huconn/HPB-01/reference/hy_ip5328_test_v10b.pdf

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
D | D
C | C
B | B
A | A
Revision | Description | Date | Drawn | Checked
V10A | init | 2020-09-27 | xxxlzjxxx
V10B | init | 2020-10-30 | xxxlzjxxx

# 02 CHARGER

# COVER

Schematics Index: | BUG

# Power Block:

# Schematics Block:

# 01 COVER

# 3.7V 100Ah TAFER电池充电板

# max/min:4.3V/2.8V

# max充电:1C 100A

# max放电:2.5C 255A

Title

Size Size Size A3 A3 A3 | Document Number Document Number Document Number 01 COVER 01 COVER 01 COVER | Rev Rev Rev V10B V10B V10B
Date: Date: Date: Friday, October 30, 2020 Friday, October 30, 2020 Friday, October 30, 2020 | Sheet Sheet Sheet 1 1 1 of of of 2 2 2

## SICHUAN HUIYUAN OPTICAL COMMUNICATIONS CO.,LTD

hyoc.com.cn | Designed | Checked | Approved

汇源光通信

HY_IP5328_TEST_V10B

Title

## SICHUAN HUIYUAN OPTICAL COMMUNICATIONS CO.,LTD

hyoc.com.cn | Designed | Checked | Approved

汇源光通信

HY_IP5328_TEST_V10B

Title

## SICHUAN HUIYUAN OPTICAL COMMUNICATIONS CO.,LTD

hyoc.com.cn | Designed | Checked | Approved

汇源光通信

HY_IP5328_TEST_V10B

5

4

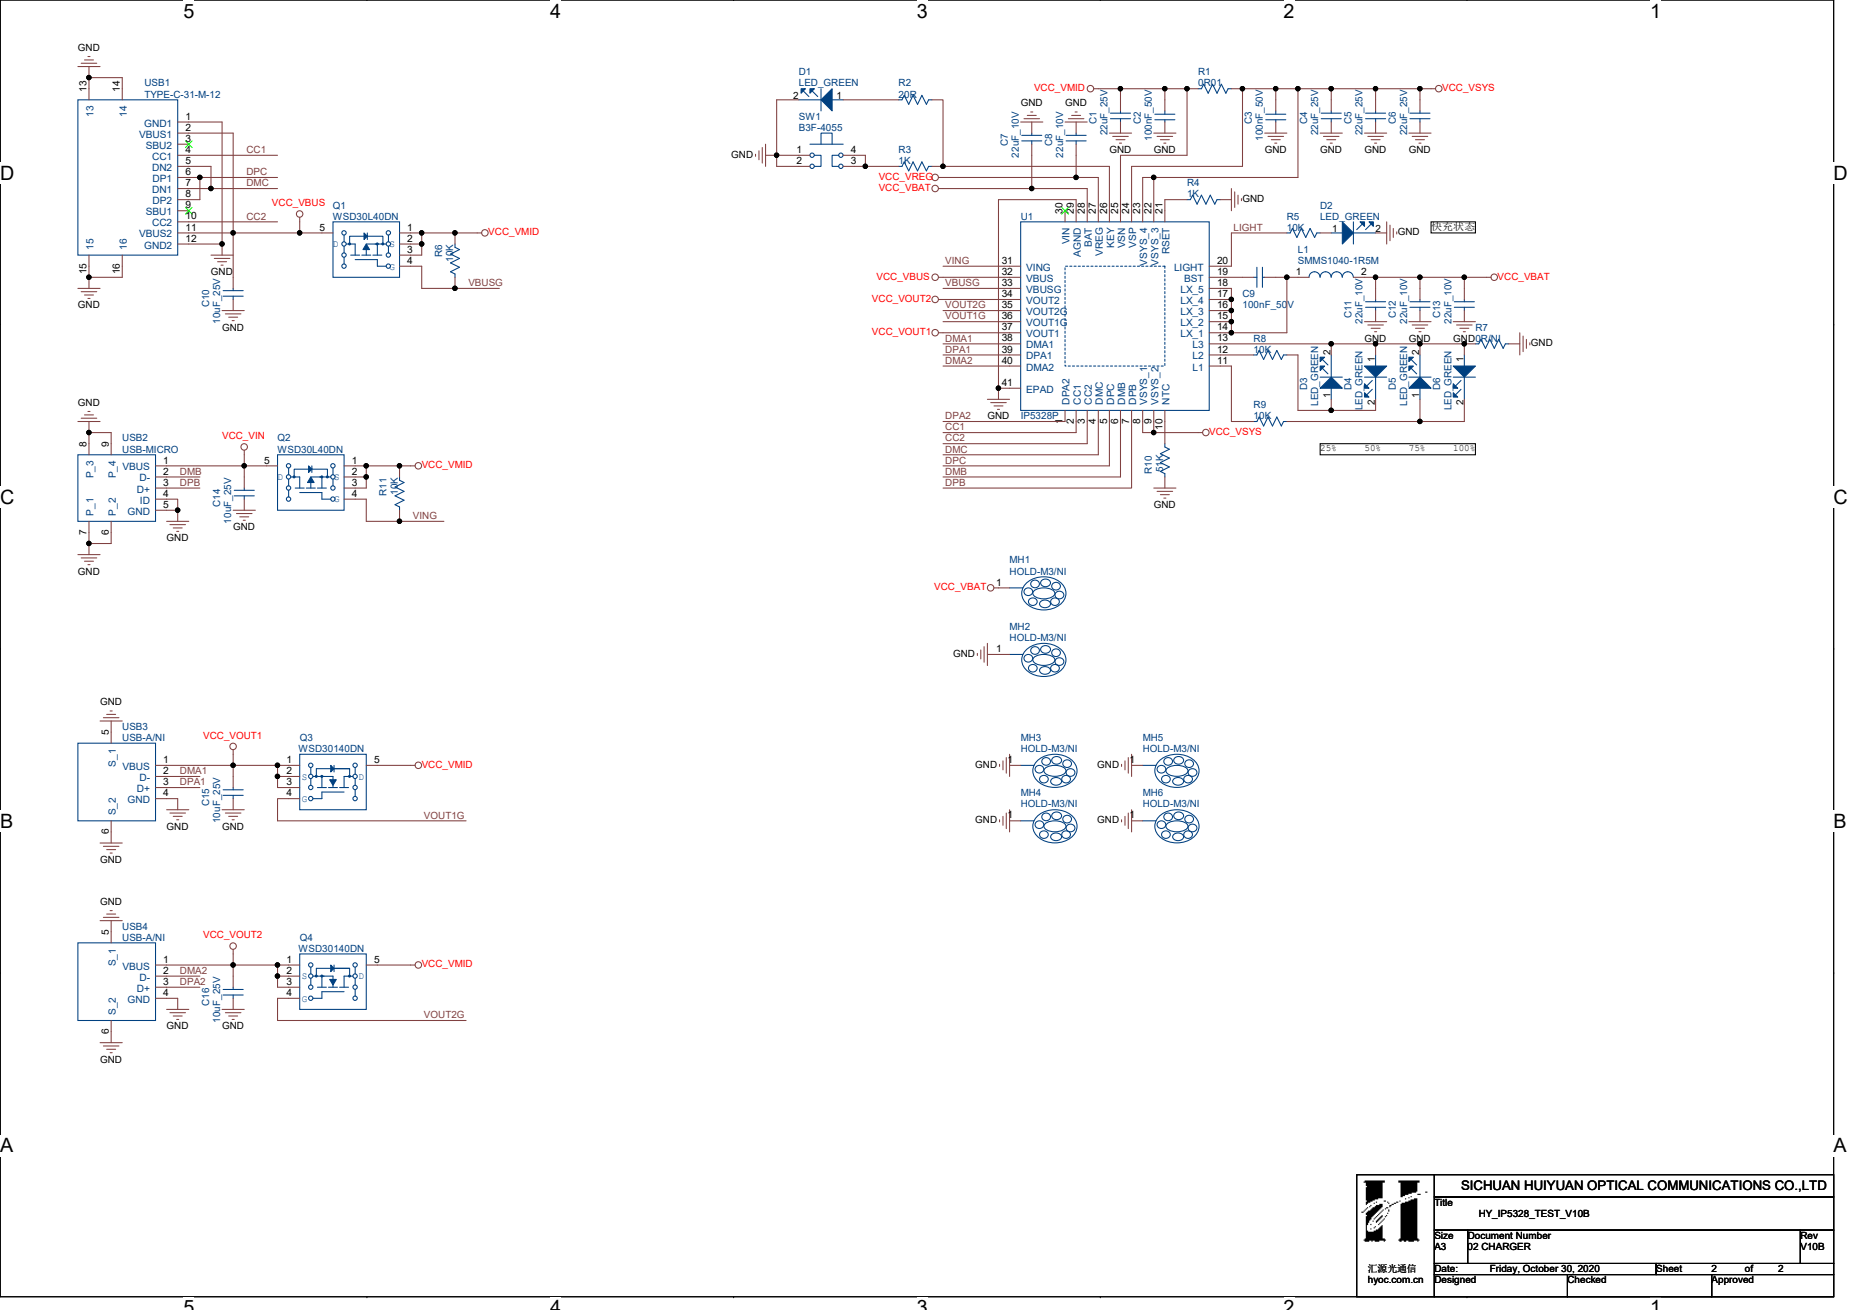
[picture p1: page 2]

SICHUAN HUIYUAN OPTICAL COMMUNICATIONS CO.,LTD
Title

Size Size Size A3 A3 A3 | Document Number Document Number Document Number 02 CHARGER 02 CHARGER 02 CHARGER | Rev Rev Rev V10B V10B V10B

Date: Date: Date: Friday, October 30, 2020 Friday, October 30, 2020 Friday, October 30, 2020 | Sheet Sheet Sheet 2 2 2 of of of 2 2 2
