huconn/HPB-01/HPB-01.kicad_pcb

## KiCad design HPB-01.kicad_pcb (2022-02-15)

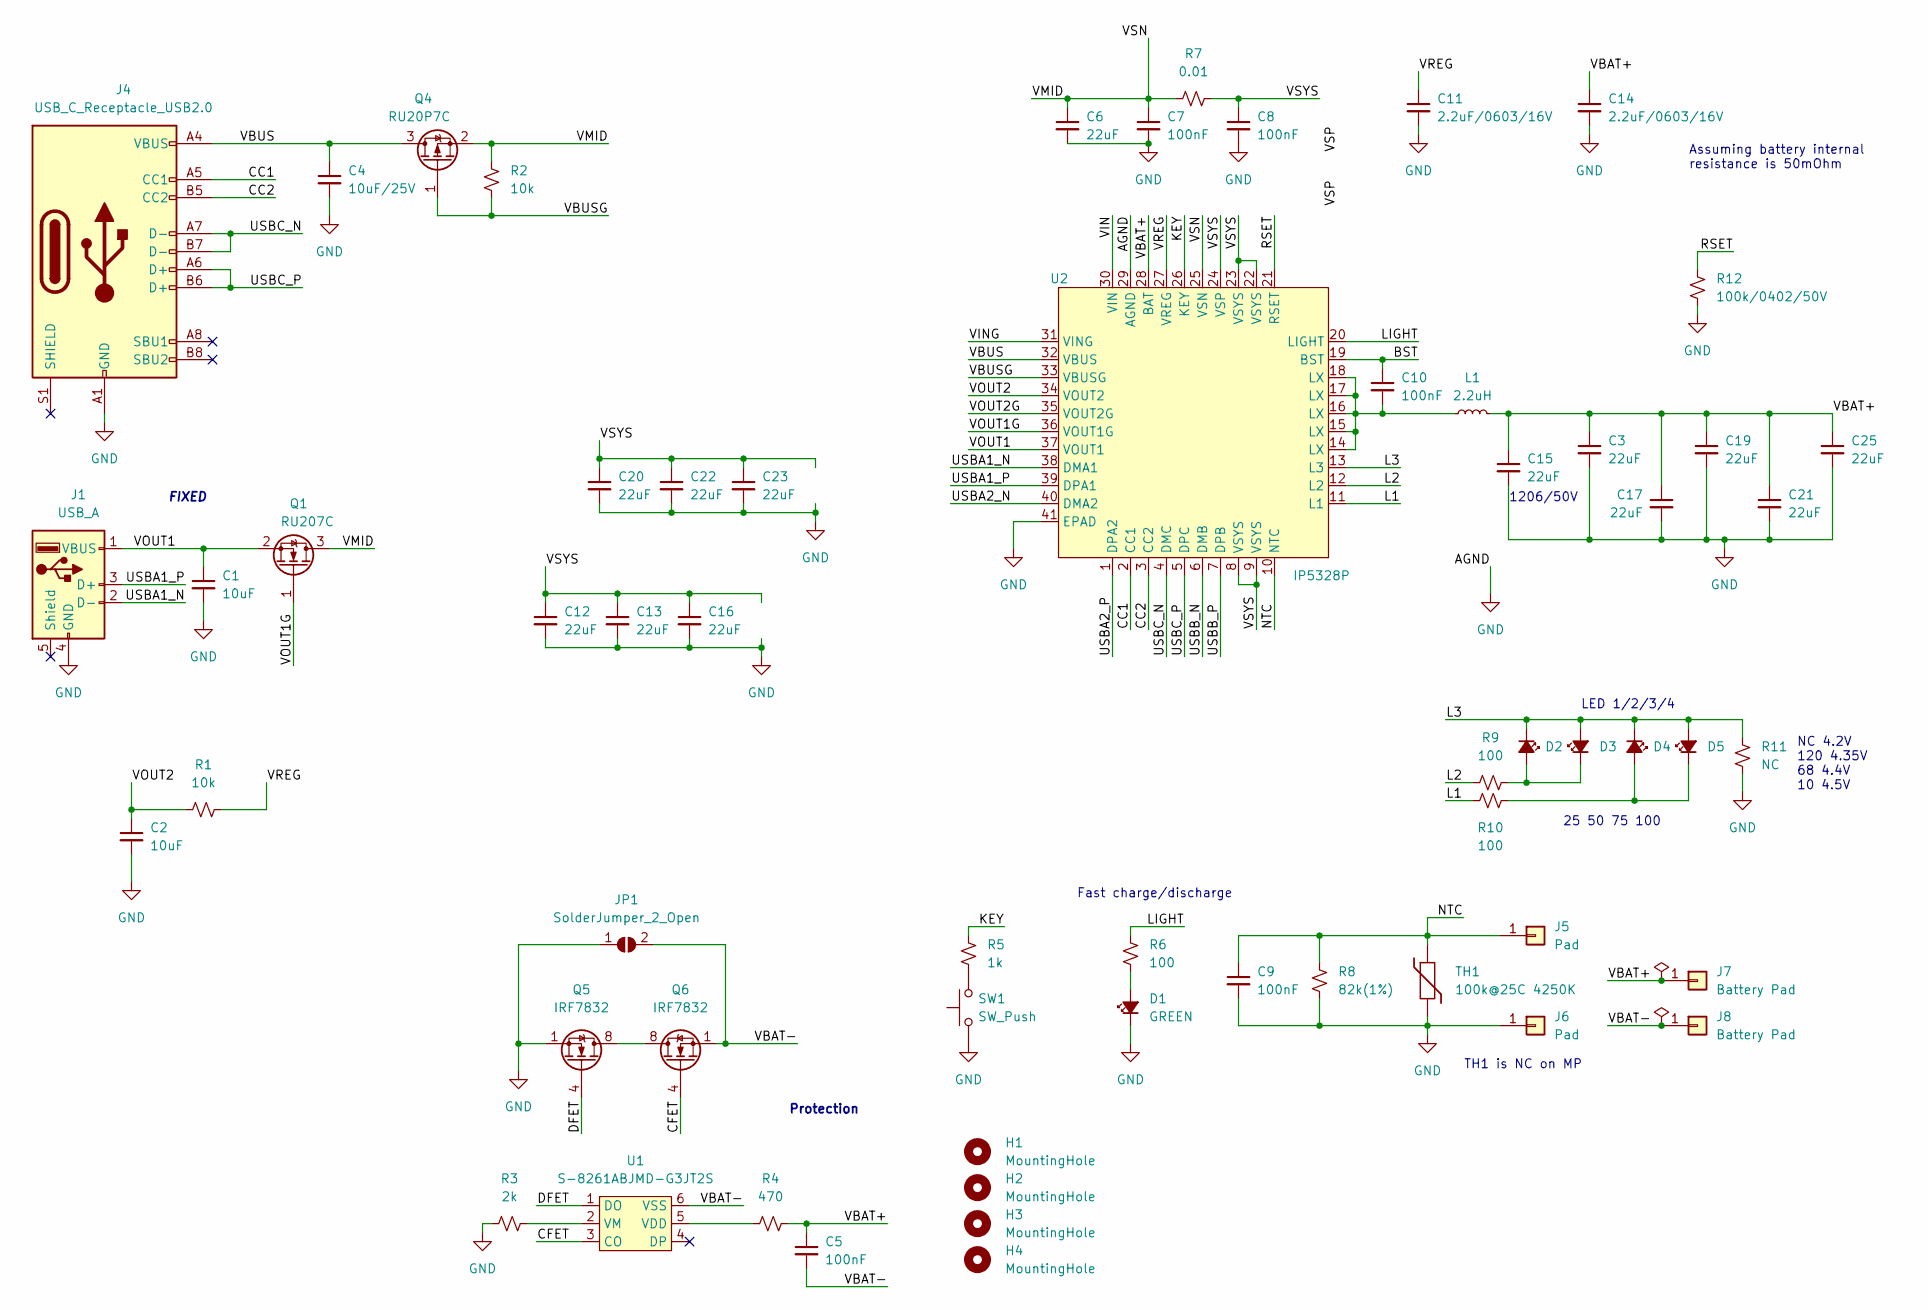
[picture p2: schematic HPB-01.kicad_sch]

Parts:
C1, C2: 10uF; C_0603_1608Metric; LCSC C96446
C3, C6, C12, C13, C15, C16, C17, C19, C20, C21, C22, C23, C25: 22uF; C_0805_2012Metric; LCSC C45783
C4: 10uF/25V; C_0603_1608Metric; LCSC C96446
C5, C7, C8, C9, C10: 100nF; C_0603_1608Metric; LCSC C14663
C11, C14: 2.2uF/0603/16V; C_0603_1608Metric; LCSC C23630
D1: GREEN; LED_0603_1608Metric; LCSC C72043
D2, D3, D4, D5: BLUE; LED_0603_1608Metric; LCSC C72041
H1, H2, H3, H4: MountingHole; MountingHole_2.2mm_M2
J1: USB_A; USB_A_FEMALE_905-662A203S10200; LCSC C41014
J4: USB_C_Receptacle_USB2.0; USB_C_Receptacle_HRO_TYPE-C-31-M-12; LCSC C165948
J5, J6: Pad; TestPoint_Pad_D1.5mm
J7, J8: Battery Pad
JP1: SolderJumper_2_Open; SolderJumper-2_P1.3mm_Open_Pad1.0x1.5mm
L1: 2.2uH; L_Wuerth_HCI-1050; LCSC C149538
Q1: RU207C; SOT-23; LCSC C515680
Q4: RU20P7C; SOT-23; LCSC C181984
Q5, Q6: IRF7832; SOIC-8_3.9x4.9mm_P1.27mm; LCSC C3002
R1, R2: 10k; R_0603_1608Metric; LCSC C25804
R3: 2k; R_0603_1608Metric; LCSC C22975
R4: 470; R_0603_1608Metric; LCSC C23179
R5: 1k; R_0603_1608Metric; LCSC C21190
R6, R9, R10: 100; R_0603_1608Metric; LCSC C22775
R7: 0.01; R_1206_3216Metric; LCSC C309628
R8: 82k(1%); R_0603_1608Metric; LCSC C23254
R11: NC; R_0603_1608Metric
R12: 100k/0402/50V; R_0402_1005Metric; LCSC C25086
SW1: SW_Push; SW_Push_1P1T-MP_NO_Horizontal_Alps_SKRTLAE010; LCSC C127481
TH1: 100k@25C 4250K; R_0603_1608Metric; LCSC C92368
U1: S-8261ABJMD-G3JT2S; SOT-23-6; LCSC C28081
U2: IP5328P; QFN-40-1EP_6x6mm_P0.5mm_EP4.6x4.6mm; LCSC C188809

Connections:
/BST: C10.1, U2.19 (BST)
/CC1: J4.A5 (CC1), U2.2 (CC1)
/CC2: J4.B5 (CC2), U2.3 (CC2)
/CFET: Q6.4 (G), U1.3 (CO)
/DFET: Q5.4 (G), U1.1 (DO)
/KEY: R5.1, U2.26 (KEY)
/L1: R10.1, U2.11 (L1)
/L2: R9.1, U2.12 (L2)
/L3: D2.1 (K), D3.2 (A), D4.1 (K), D5.2 (A), R11.1, U2.13 (L3)
/LIGHT: R6.1, U2.20 (LIGHT)
/NTC: C9.1, J5.1, R8.1, TH1.1, U2.10 (NTC)
/RSET: R12.1, U2.21 (RSET)
/USBA1_N: J1.2 (D-), U2.38 (DMA1)
/USBA1_P: J1.3 (D+), U2.39 (DPA1)
/USBA2_N: U2.40 (DMA2)
/USBA2_P: U2.1 (DPA2)
/USBB_N: U2.6 (DMB)
/USBB_P: U2.7 (DPB)
/USBC_N: J4.A7 (D-), J4.B7 (D-), U2.4 (DMC)
/USBC_P: J4.A6 (D+), J4.B6 (D+), U2.5 (DPC)
/VBAT+: C3.1, C5.1, C14.1, C15.1, C17.1, C19.1, C21.1, C25.1, J7.1, L1.2, R4.2, U2.28 (BAT)
/VBAT-: C5.2, J8.1, JP1.2 (B), Q6.1 (S), Q6.2 (S), Q6.3 (S), U1.6 (VSS)
/VBUS: C4.1, J4.A4 (VBUS), J4.A9 (VBUS), J4.B4 (VBUS), J4.B9 (VBUS), Q4.3 (D), U2.32 (VBUS)
/VBUSG: Q4.1 (G), R2.2, U2.33 (VBUSG)
/VIN: U2.30 (VIN)
/VING: U2.31 (VING)
/VMID: C6.1, C7.1, Q1.3 (D), Q4.2 (S), R2.1, R7.1, U2.25 (VSN)
/VOUT1: C1.1, J1.1 (VBUS), Q1.2 (S), U2.37 (VOUT1)
/VOUT1G: Q1.1 (G), U2.36 (VOUT1G)
/VOUT2: C2.1, R1.1, U2.34 (VOUT2)
/VOUT2G: U2.35 (VOUT2G)
/VREG: C11.1, R1.2, U2.27 (VREG)
/VSYS: C8.1, C12.1, C13.1, C16.1, C20.1, C22.1, C23.1, R7.2, U2.8 (VSYS), U2.9 (VSYS), U2.22 (VSYS), U2.23 (VSYS), U2.24 (VSP)
GND: C1.2, C2.2, C3.2, C4.2, C6.2, C7.2, C8.2, C9.2, C11.2, C12.2, C13.2, C14.2, C15.2, C16.2, C17.2, C19.2, C20.2, C21.2, C22.2, C23.2, C25.2, D1.1 (K), J1.4 (GND), J4.A1 (GND), J4.A12 (GND), J4.B1 (GND), J4.B12 (GND), J6.1, JP1.1 (A), Q5.1 (S), Q5.2 (S), Q5.3 (S), R3.1, R8.2, R11.2, R12.2, SW1.1, TH1.2, U2.29 (AGND), U2.41 (EPAD)
unnamed: C10.2, L1.1, U2.14 (LX), U2.15 (LX), U2.16 (LX), U2.17 (LX), U2.18 (LX)
unnamed: D1.2 (A), R6.2
unnamed: D2.2 (A), D3.1 (K), R9.2
unnamed: D4.2 (A), D5.1 (K), R10.2
unnamed: Q5.5 (D), Q5.6 (D), Q5.7 (D), Q5.8 (D), Q6.5 (D), Q6.6 (D), Q6.7 (D), Q6.8 (D)
unnamed: R3.2, U1.2 (VM)
unnamed: R4.1, U1.5 (VDD)
unnamed: R5.2, SW1.2

Notes on the sheet:
FIXED
LED 1/2/3/4
Protection
TH1 is NC on MP
Fast charge/discharge
25 50 75 100
1206/50V
Assuming battery internal resistance is 50mOhm
NC 4.2V 120 4.35V 68 4.4V 10 4.5V

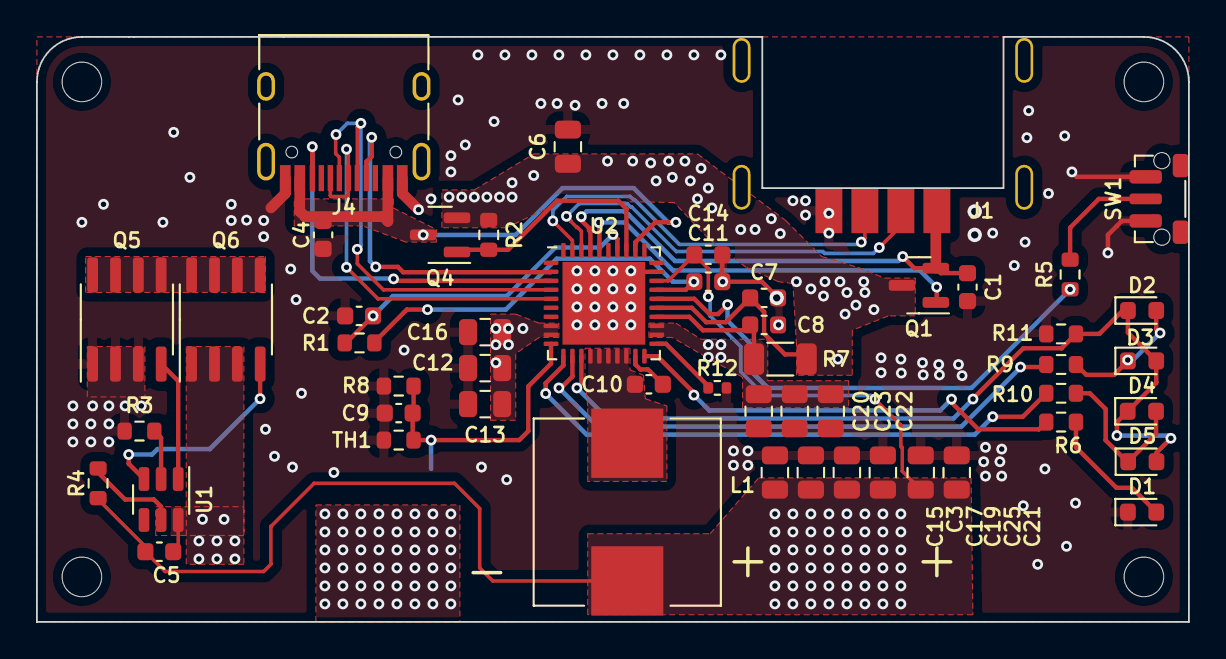
[picture p3: board HPB-01.kicad_pcb from above]

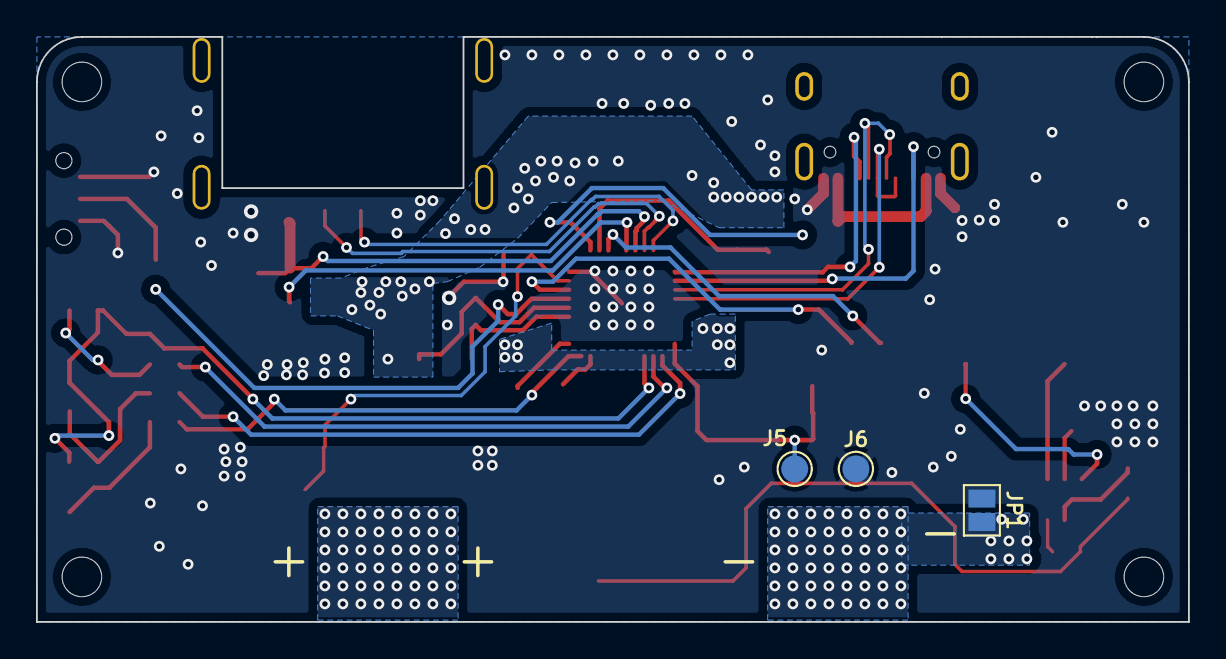
[picture p4: board HPB-01.kicad_pcb from below]

Board: 4 copper layers, 64.0 x 32.5 mm, 58 parts (3 on the bottom side), 35 nets.
