huconn/HPB-01/(commit log)

2021-09-30 ERC and DRC correction
    [HPB-01.kicad_pcb, HPB-01.kicad_sch]
2022-01-17 Change the layout (bigger)
    [HPB-01.kicad_pcb, HPB-01.kicad_sch]
2022-01-18 [WIP] positioning parts on new layout (90%)
    [HPB-01.kicad_pcb, HPB-01.kicad_sch]
2022-01-18 Add some comment for MP
    Add 3D part archive
    [HPB-01.kicad_pcb, HPB-01.kicad_sch]
2022-01-23 PCB artwork complete
    [HPB-01.kicad_pcb]
2022-01-23 update library and 3d model
    [HPB-01.kicad_sch]
2022-02-14 WIP: bug fix and make some improvement
    [HPB-01.kicad_pcb, HPB-01.kicad_sch]
2022-02-15 revision 1.1
    [HPB-01.kicad_pcb, HPB-01.kicad_sch]
